T3nk4I/Minisumo/PCBS/Boards/Tei/Production/production/bom.csv

Designator | Footprint | Quantity | Value | LCSC Part #
A1_3, A1_2, A1 | Arduino_Nano | 3 | Arduino_Nano_v3.x
BLUETOOTH ADAPTER_3, BLUETOOTH ADAPTER_2, BLUETOOTH ADAPTER, REMOTE_3, REMOTE_2, REMOTE | PinSocket_1x04_P2.54mm_Vertical | 6 | Conn_01x04_Socket
C1_3, C1_2, C1 | 0805 | 3 | 10uf
C2_3, C2_2, C2 | 0805 | 3 | 22uf
C3_3, C3_2, C3, C4_3, C4_2, C4 | 0805 | 6 | 0.1uF
C5_3, C5_2, C5 | CP_EIA-3216-18_Kemet-A | 3 | 10uf
D1_3, D1_2, D1 | 0805 | 3 | LED
H1_3, H1_2, H1, H2_3, H2_2, H2, H3_3, H3_2, H3, H4_3, H4_2, H4 | MountingHole_2.2mm_M2 | 12 | MountingHole
J1_3, J1_2, J1 | AMASS_XT30U-F_1x02_P5.0mm_Vertical | 3 | Conn_01x02_Socket
J12_3, J12_2, J12, J2_3, J2_2, J2, J3_3, J3_2, J3, J4_3, J4_2, J4, J5_3, J5_2, J5, J6_3, J6_2, J6, J7_3, J7_2, J7, J8_3, J8_2, J8, J9_3, J9_2, J9 | PinHeader_1x03_P2.54mm_Vertical | 27 | Conn_01x03_Pin
J13_3, J13_2, J13, J14_3, J14_2, J14 | JST_XH_B2B-XH-A_1x02_P2.50mm_Vertical | 6 | Conn_01x02_Socket
R1_3, R1_2, R1 | 0805 | 3 | 300
R2_3, R2_2, R2, R3_3, R3_2, R3, R4_3, R4_2, R4, R5_3, R5_2, R5 | 0805 | 12 | 4.7k
SW1_3, SW1_2, SW1 | SW_SPDT_PCM12 | 3 | SW_SPDT
SW2_3, SW2_2, SW2 | Nidec_Copal_SH-7010A | 3 | SW_Coded_SH-7010
U1_3, U1_2, U1 | SSOP-24_5.3x8.2mm_P0.65mm | 3 | TB6612FNG
U2_3, U2_2, U2 | SOT-223-3_TabPin2 | 3 | AMS1117-5.0
