T3nk4I/Minisumo/PCBS/Boards/Tenn/Tenn.csv

Reference | Value | Datasheet | Footprint | Qty | DNP
A1 | Arduino_Nano_v3.x | http://www.mouser.com/pdfdocs/Gravitech_Arduino_Nano3_0.pdf | Module:Arduino_Nano | 1
C1,C2 | C | ~ | Capacitor_SMD:C_0805_2012Metric_Pad1.18x1.45mm_HandSolder | 2
C3,C4 | 0.1uF | ~ | Capacitor_SMD:C_0805_2012Metric_Pad1.18x1.45mm_HandSolder | 2
C5,C6 | 47uF | ~ | Capacitor_SMD:C_1206_3216Metric_Pad1.33x1.80mm_HandSolder | 2
J1 | Conn_01x02_Socket | ~ | Connector_AMASS:AMASS_XT30U-M_1x02_P5.0mm_Vertical | 1
J12 | Conn_01x04_Female | ~ | Connector_PinSocket_2.54mm:PinSocket_1x04_P2.54mm_Vertical | 1
J13,J14,J15 | Conn_01x03_Male | ~ | Connector_PinHeader_2.54mm:PinHeader_1x03_P2.54mm_Vertical,Connector_PinSocket_2.54mm:PinSocket_1x03_P2.54mm_Vertical | 3
J16,J17 | Conn_01x02_Male | ~ | Connector_JST:JST_XH_B2B-XH-A_1x02_P2.50mm_Vertical | 2
J18 | Conn_01x30_Pin | ~ | Connector_PinSocket_2.54mm:PinSocket_1x30_P2.54mm_Vertical | 1
R1,R2 | R | ~ | Resistor_SMD:R_0805_2012Metric_Pad1.20x1.40mm_HandSolder | 2
R3,R4 | 18k | ~ | Resistor_SMD:R_0805_2012Metric_Pad1.20x1.40mm_HandSolder | 2
SW2,SW3 | SW_Push | ~ | Button_Switch_SMD:SW_Push_1P1T_NO_Vertical_Wuerth_434133025816 | 2
SW4 | SW_SPDT | ~ | Button_Switch_THT:SW_Slide_SPDT_Straight_CK_OS102011MS2Q | 1
U1 | L7805 | http://www.st.com/content/ccc/resource/technical/document/datasheet/41/4f/b3/b0/12/d4/47/88/CD00000444.pdf/files/CD00000444.pdf/jcr:content/translations/en.CD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 | Package_TO_SOT_SMD:TO-252-2 | 1
U2,U3 | DRV8871DDA | http://www.ti.com/lit/ds/symlink/drv8871.pdf | Package_SO:Texas_HTSOP-8-1EP_3.9x4.9mm_P1.27mm_EP2.95x4.9mm_Mask2.4x3.1mm_ThermalVias | 2
