T3nk4I/Minisumo/PCBS/Boards/Ma/Ma/Ma.csv

Reference | Qty | Value | DNP | Exclude from BOM | Exclude from Board | Footprint | Datasheet
C1,C2,C3,C5,C10,C13 | 6 | 0.1uF |  |  |  | Capacitor_SMD:C_0805_2012Metric | ~
C4 | 1 | 4.7uF |  |  |  | Capacitor_SMD:C_0805_2012Metric | ~
C11,C12 | 2 | 470uF |  |  |  | Capacitor_SMD:CP_Elec_8x10.5 | ~
D1,D2 | 2 | LED |  |  |  | LED_SMD:LED_0603_1608Metric | ~
H1,H2,H3,H4 | 4 | MountingHole |  | Excluded from BOM |  | MountingHole:MountingHole_2.2mm_M2 | ~
J1 | 1 | Conn_01x02_Socket |  |  |  | Connector_AMASS:AMASS_XT30U-M_1x02_P5.0mm_Vertical | ~
J2,J9 | 2 | Conn_01x04_Socket |  |  |  | Connector_PinSocket_2.54mm:PinSocket_1x04_P2.54mm_Vertical | ~
J3,J4 | 2 | Conn_01x02_Pin |  |  |  | Connector_JST:JST_XH_B2B-XH-A_1x02_P2.50mm_Vertical | ~
J5 | 1 | Conn_01x03_Pin |  |  |  | Package_TO_SOT_SMD:TO-252-2 | ~
J7 | 1 | Conn_01x03_Pin |  |  |  | EasyEDA:HDR-SMD_3P-P2.54-H-M-W13.3-N | ~
J8 | 1 | Conn_01x06_Socket |  |  |  | EasyEDA:HDR-SMD_6P-P2.54-H-F-W11.7 | ~
J10 | 1 | Conn_01x14_Pin |  |  |  | Connector_PinHeader_2.54mm:PinHeader_1x14_P2.54mm_Vertical | ~
R1,R2,R3,R4,R5,R6,R7 | 7 | R |  |  |  | Resistor_SMD:R_0603_1608Metric | ~
SW1 | 1 | SW_Push |  |  |  | Button_Switch_SMD:SW_Push_SPST_NO_Alps_SKRK | ~
SW2 | 1 | SW_SPDT |  |  |  | EasyEDA:SW-TH_XKB_SS-12M11XX | ~
SW3,SW4 | 2 | SW_Push |  |  |  | Button_Switch_SMD:SW_SPST_PTS810 | ~
U1 | 1 | ATmega328P-M |  |  |  | Package_DFN_QFN:QFN-32-1EP_5x5mm_P0.5mm_EP3.1x3.1mm | http://ww1.microchip.com/downloads/en/DeviceDoc/ATmega328_P%20AVR%20MCU%20with%20picoPower%20Technology%20Data%20Sheet%2040001984A.pdf
U3,U4 | 2 | ~ |  |  |  | Package_SO:SOP-8_3.9x4.9mm_P1.27mm
Y1 | 1 | Crystal |  |  |  | Crystal:Crystal_SMD_3215-2Pin_3.2x1.5mm | ~
