T3nk4I/Minisumo/PCBS/Boards/Inn BEC/Production/production/bom.csv

Designator | Footprint | Quantity | Value | LCSC Part #
C1_40, C1_39, C1_38, C1_37, C1_36, C1_35, C1_34, C1_33, C1_32, C1_31, C1_30, C1_29, C1_28, C1_27, C1_26, C1_25, C1_24, C1_23, C1_22, C1_21, C1_20, C1_19, C1_18, C1_17, C1_16, C1_15, C1_14, C1_13, C1_12, C1_11, C1_10, C1_9, C1_8, C1_7, C1_6, C1_5, C1_4, C1_3, C1_2, C1 | 0805 | 40 | 22uF
C2_40, C2_39, C2_38, C2_37, C2_36, C2_35, C2_34, C2_33, C2_32, C2_31, C2_30, C2_29, C2_28, C2_27, C2_26, C2_25, C2_24, C2_23, C2_22, C2_21, C2_20, C2_19, C2_18, C2_17, C2_16, C2_15, C2_14, C2_13, C2_12, C2_11, C2_10, C2_9, C2_8, C2_7, C2_6, C2_5, C2_4, C2_3, C2_2, C2 | 1210 | 40 | 47uF
D1_40, D1_39, D1_38, D1_37, D1_36, D1_35, D1_34, D1_33, D1_32, D1_31, D1_30, D1_29, D1_28, D1_27, D1_26, D1_25, D1_24, D1_23, D1_22, D1_21, D1_20, D1_19, D1_18, D1_17, D1_16, D1_15, D1_14, D1_13, D1_12, D1_11, D1_10, D1_9, D1_8, D1_7, D1_6, D1_5, D1_4, D1_3, D1_2, D1 | D_SMA | 40 | D_Schottky
J1_40, J1_39, J1_38, J1_37, J1_36, J1_35, J1_34, J1_33, J1_32, J1_31, J1_30, J1_29, J1_28, J1_27, J1_26, J1_25, J1_24, J1_23, J1_22, J1_21, J1_20, J1_19, J1_18, J1_17, J1_16, J1_15, J1_14, J1_13, J1_12, J1_11, J1_10, J1_9, J1_8, J1_7, J1_6, J1_5, J1_4, J1_3, J1_2, J1, J2_40, J2_39, J2_38, J2_37, J2_36, J2_35, J2_34, J2_33, J2_32, J2_31, J2_30, J2_29, J2_28, J2_27, J2_26, J2_25, J2_24, J2_23, J2_22, J2_21, J2_20, J2_19, J2_18, J2_17, J2_16, J2_15, J2_14, J2_13, J2_12, J2_11, J2_10, J2_9, J2_8, J2_7, J2_6, J2_5, J2_4, J2_3, J2_2, J2 | SolderWire-0.1sqmm_1x02_P3.6mm_D0.4mm_OD1mm | 80 | Conn_01x02_Pin
L1_40, L1_39, L1_38, L1_37, L1_36, L1_35, L1_34, L1_33, L1_32, L1_31, L1_30, L1_29, L1_28, L1_27, L1_26, L1_25, L1_24, L1_23, L1_22, L1_21, L1_20, L1_19, L1_18, L1_17, L1_16, L1_15, L1_14, L1_13, L1_12, L1_11, L1_10, L1_9, L1_8, L1_7, L1_6, L1_5, L1_4, L1_3, L1_2, L1 | L_Bourns-SRN4018 | 40 | 68uH
U1_40, U1_39, U1_38, U1_37, U1_36, U1_35, U1_34, U1_33, U1_32, U1_31, U1_30, U1_29, U1_28, U1_27, U1_26, U1_25, U1_24, U1_23, U1_22, U1_21, U1_20, U1_19, U1_18, U1_17, U1_16, U1_15, U1_14, U1_13, U1_12, U1_11, U1_10, U1_9, U1_8, U1_7, U1_6, U1_5, U1_4, U1_3, U1_2, U1 | SOIC-8_3.9x4.9mm_P1.27mm | 40 | XL1509-5.0
