T3nk4I/Minisumo/PCBS/Sensors/QTMicro/Pinout and component placement.png

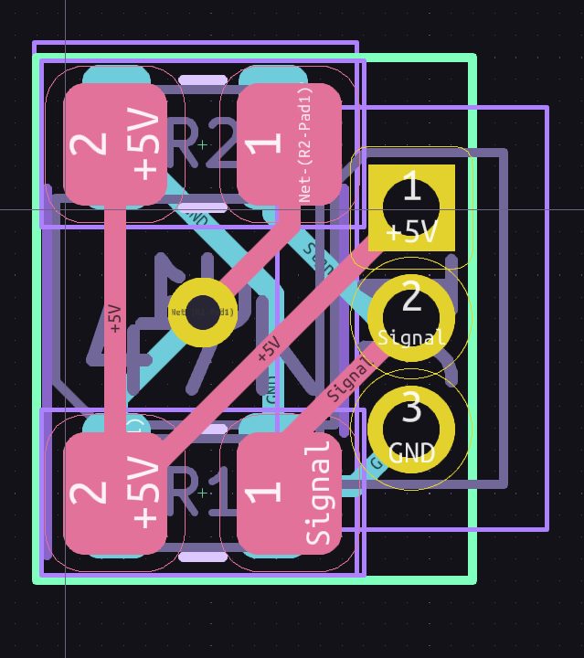
PCBS/Sensors/QTMicro/Pinout and component placement.png
