T3nk4I/Minisumo/3D data/Flag system/Damashi Flag system.iges

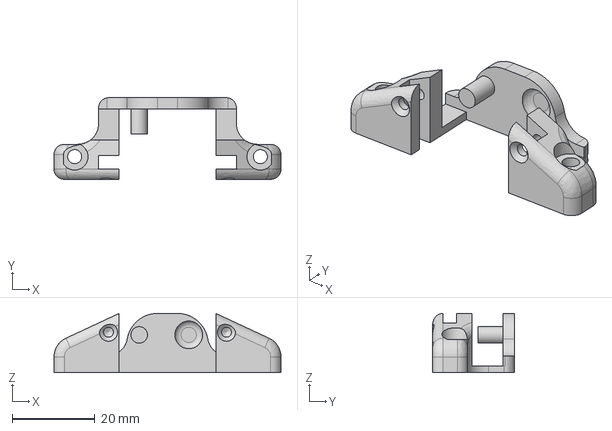
[picture p2: CAD file, 2024-06-04]
3D data/Flag system/Damashi Flag system.iges
55.0 x 19.8 x 14.4 mm
