T3nk4I/Minisumo/3D data/Motor Brackets/Jin/Jin v2.iges

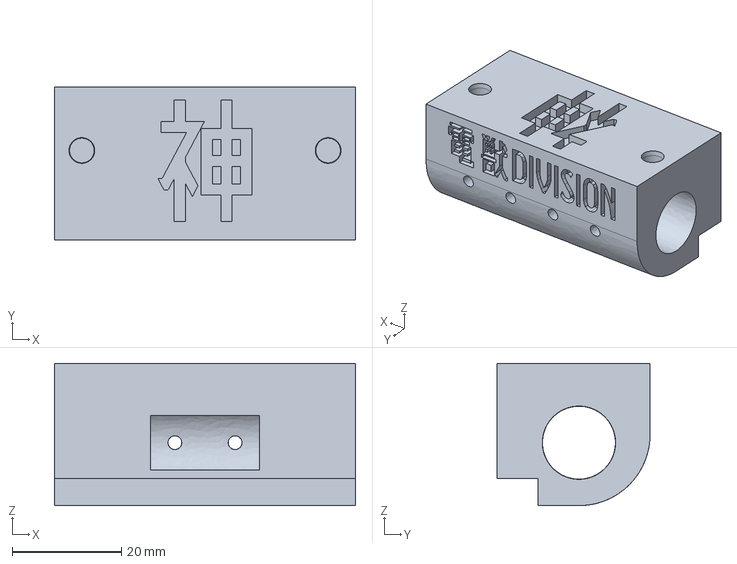
[picture p3: CAD file, 2024-02-26]
3D data/Motor Brackets/Jin/Jin v2.iges
55.0 x 28.0 x 26.0 mm
