T3nk4I/Minisumo/3D data/Motor Brackets/Oh/Oh-Motor Bracket v28.iges

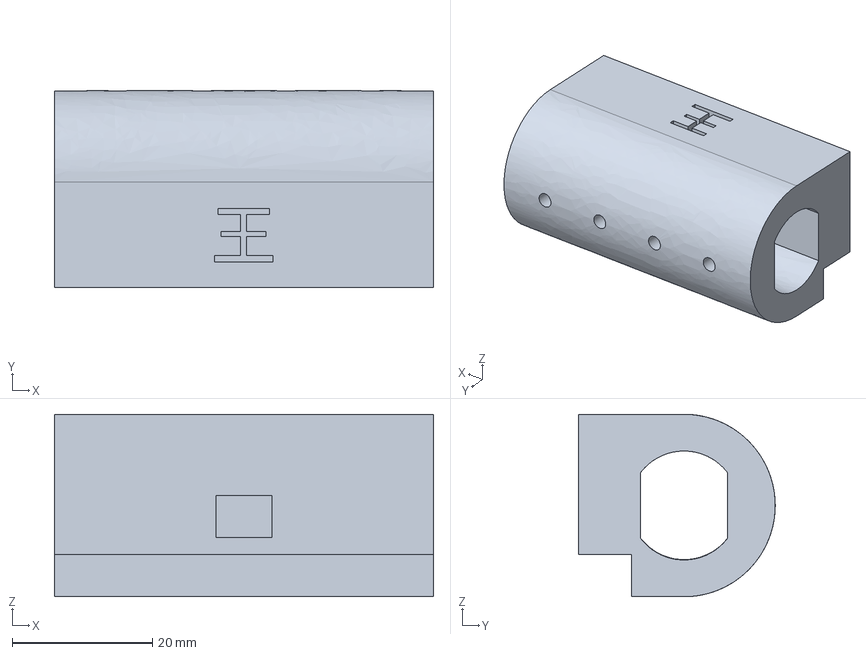
[picture p4: CAD file, 2024-02-26]
3D data/Motor Brackets/Oh/Oh-Motor Bracket v28.iges
54.0 x 28.0 x 26.0 mm
