T3nk4I/Minisumo/3D data/Robots/Gyu-Ma-Oh/Gyu Base.iges

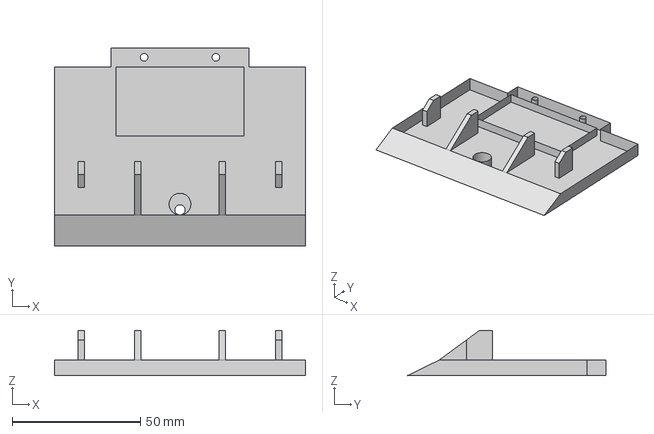
[picture p5: CAD file, 2024-05-06]
3D data/Robots/Gyu-Ma-Oh/Gyu Base.iges
98.0 x 77.5 x 17.6 mm
