T3nk4I/Minisumo/3D data/Robots/K1tsun3/Base-K1tsun3.iges

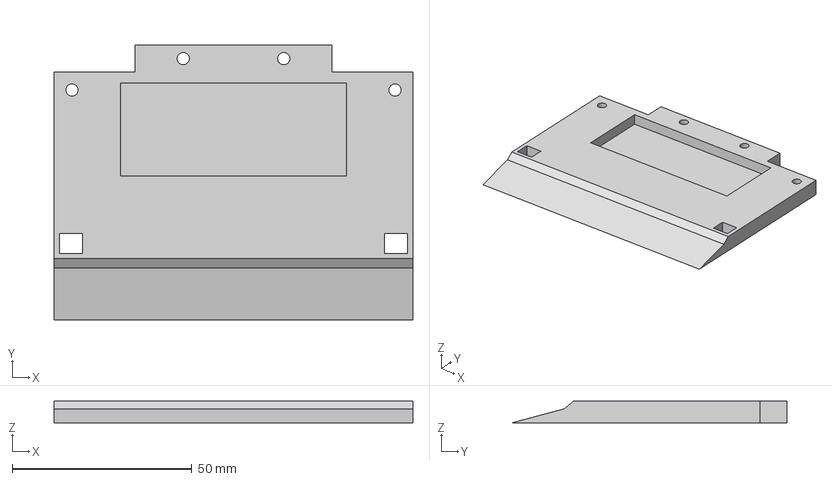
[picture p6: CAD file, 2024-05-06]
3D data/Robots/K1tsun3/Base-K1tsun3.iges
100.0 x 76.5 x 6.00 mm
