T3nk4I/Minisumo/3D data/Robots/T4nook1/Chasis T4nook1 Jsumo-Ver.iges

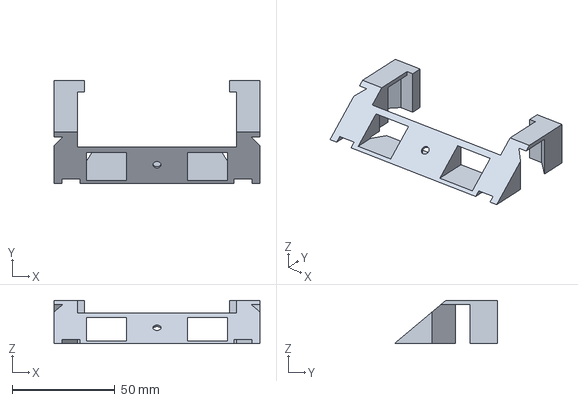
[picture p7: CAD file, 2024-05-06]
3D data/Robots/T4nook1/Chasis T4nook1 Jsumo-Ver.iges
100.0 x 50.2 x 21.0 mm
