T3nk4I/Minisumo/Microsumos/3D files/Wheel.stl

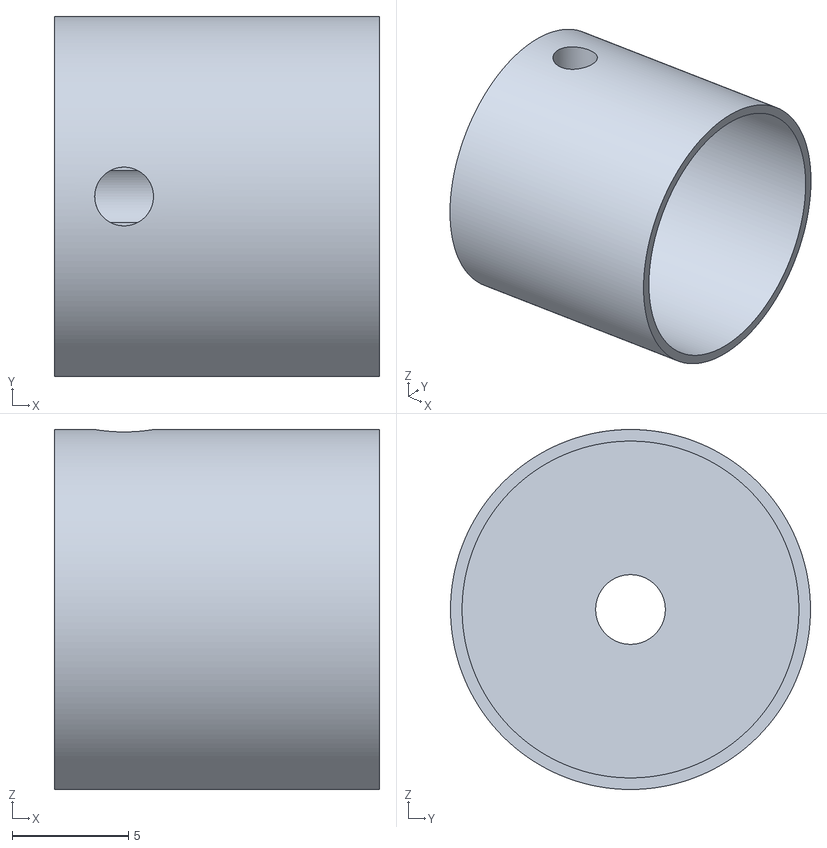
[picture p8: CAD file, 2023-09-21]
Microsumos/3D files/Wheel.stl
14.0 x 15.5 x 15.5
