T3nk4I/Minisumo/3D data/Flag system/Gear Right Flag system long stem.stl

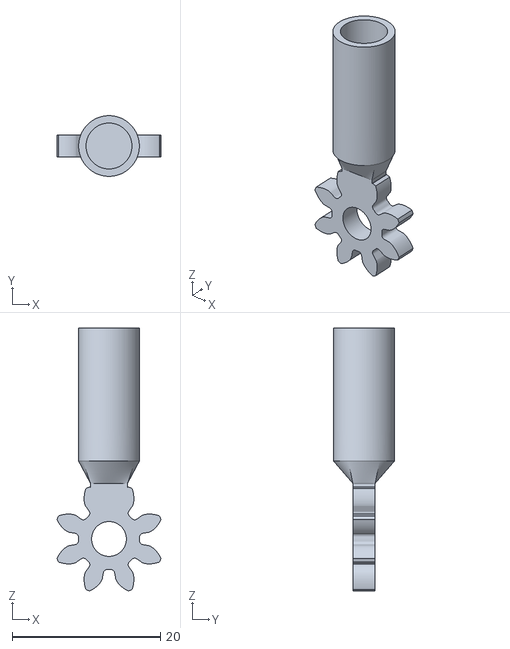
[picture p9: CAD file, 2024-06-04]
3D data/Flag system/Gear Right Flag system long stem.stl
14.1 x 8.20 x 35.5
