T3nk4I/Minisumo/3D data/Robots/Gyu-Ma-Oh/Chasis Gyu-Ma-Oh.iges

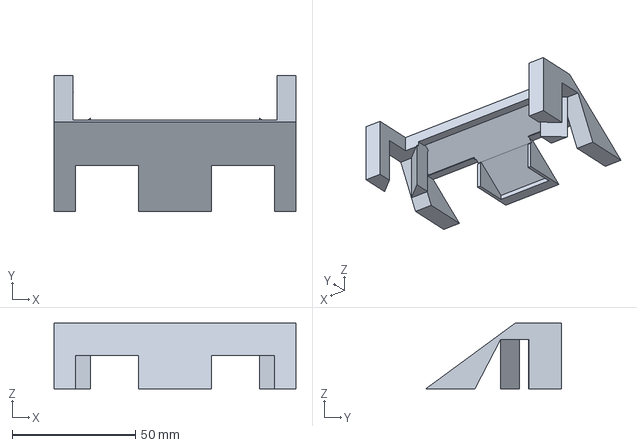
[picture p10: CAD file, 2024-05-06]
3D data/Robots/Gyu-Ma-Oh/Chasis Gyu-Ma-Oh.iges
98.0 x 55.0 x 26.6 mm
