T3nk4I/Minisumo/3D data/Robots/K1tsun3/Chasis K1tsun3.iges

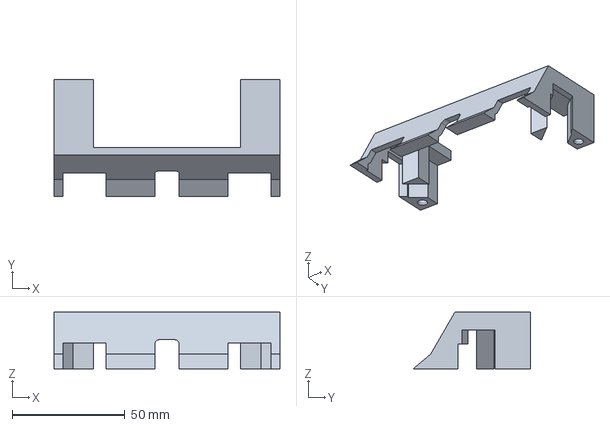
[picture p11: CAD file, 2024-05-06]
3D data/Robots/K1tsun3/Chasis K1tsun3.iges
100.0 x 52.0 x 25.0 mm
