T3nk4I/Minisumo/3D data/Robots/T4nook1/Base T4nook1.iges

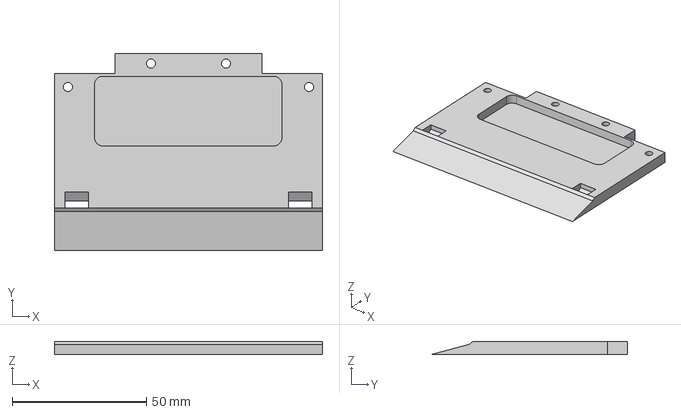
[picture p12: CAD file, 2024-05-06]
3D data/Robots/T4nook1/Base T4nook1.iges
100.0 x 73.5 x 5.00 mm
