T3nk4I/Minisumo/Microsumos/3D files/Wheel with gear.stl

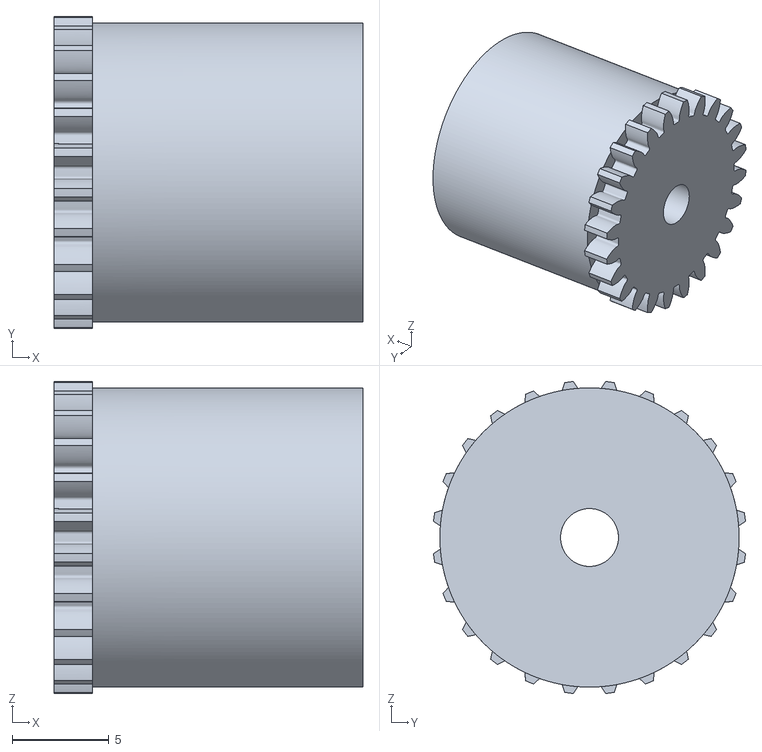
[picture p13: CAD file, 2023-09-21]
Microsumos/3D files/Wheel with gear.stl
16.0 x 16.2 x 16.2
