T3nk4I/Minisumo/3D data/Flag system/Gear Left Flag system long stem.stl

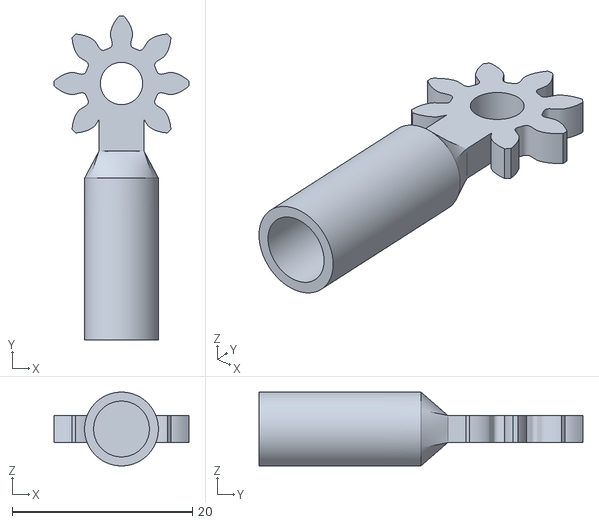
[picture p14: CAD file, 2024-06-04]
3D data/Flag system/Gear Left Flag system long stem.stl
15.0 x 36.0 x 8.20
