T3nk4I/Minisumo/Microsumos/3D files/Base.stl

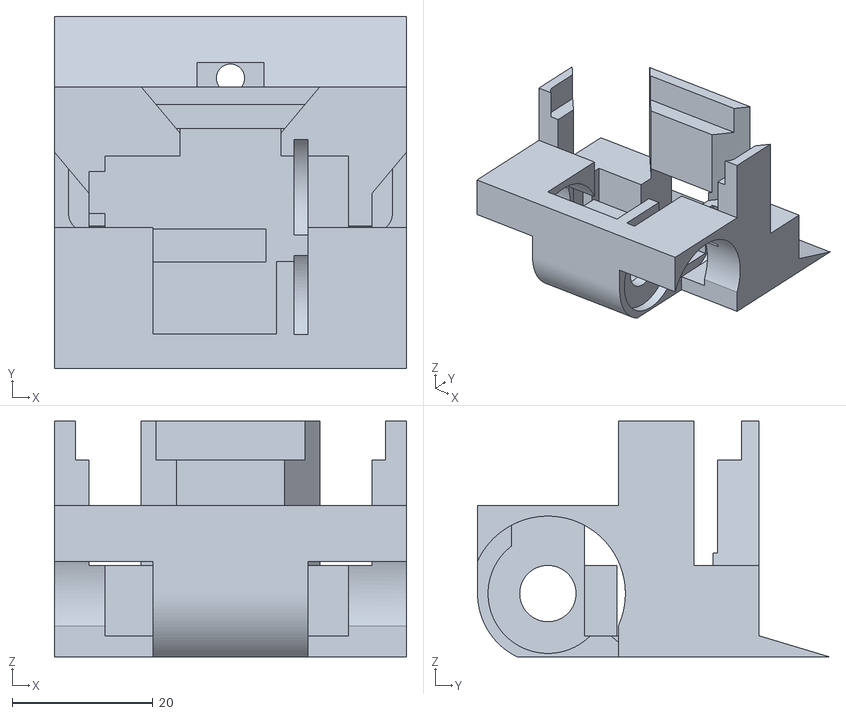
[picture p15: CAD file, 2023-09-21]
Microsumos/3D files/Base.stl
50.0 x 50.0 x 33.5
