T3nk4I/Minisumo/3D data/Flag system/Gear Right.iges

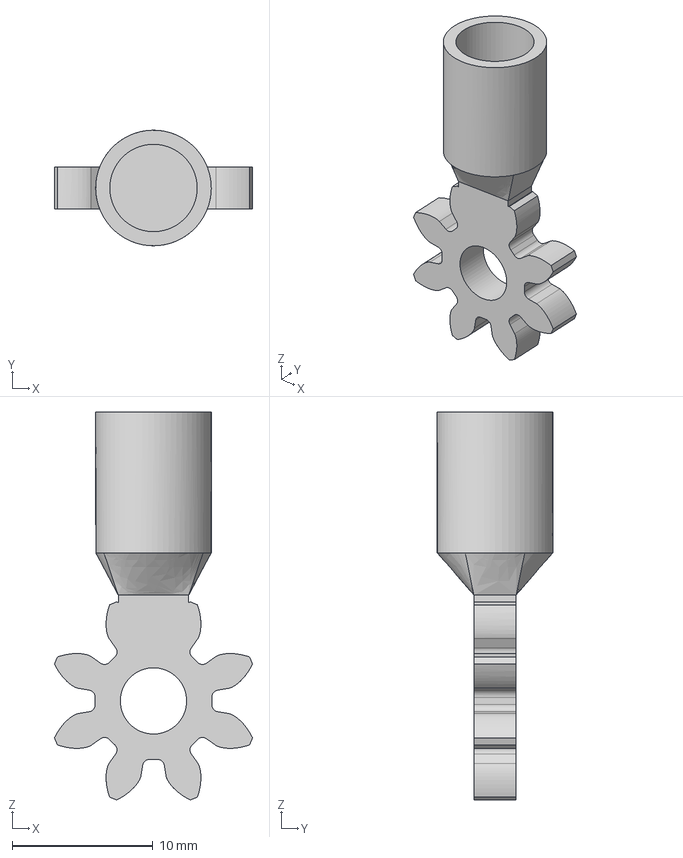
[picture p16: CAD file, 2023-11-21]
3D data/Flag system/Gear Right.iges
14.1 x 8.20 x 27.5 mm
