T3nk4I/Minisumo/Microsumos/3D files/Spur Gear (24 teeth).stl

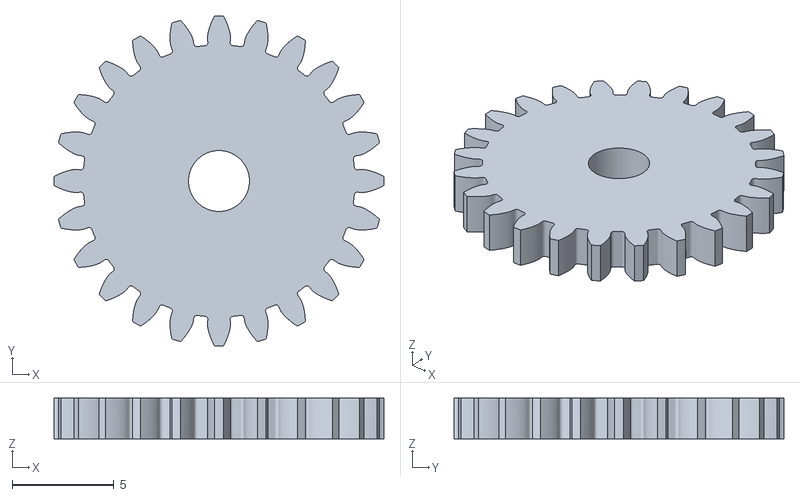
[picture p17: CAD file, 2023-09-21]
Microsumos/3D files/Spur Gear (24 teeth).stl
16.2 x 16.2 x 2.00
