T3nk4I/Minisumo/3D data/Flag system/Gear Left.iges

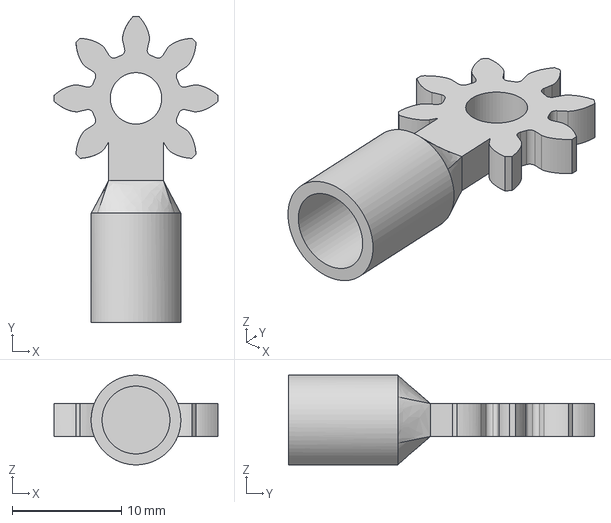
[picture p18: CAD file, 2023-11-21]
3D data/Flag system/Gear Left.iges
15.0 x 28.0 x 8.19 mm
