T3nk4I/Minisumo/(list of files, cad)

Other CAD files:
3D data/Motor Brackets/Ma-Jin/Ma-Jin.iges
3D data/Flag system/Damashi Flag system.stl
3D data/Flag system/Gear Left.stl
3D data/Flag system/Gear Right.stl
3D data/Motor Brackets/Jin/Jin v2.stl
3D data/Motor Brackets/Ma-Jin/Ma-Jin.stl
3D data/Motor Brackets/Oh/Oh-Motor Bracket v28.stl
