T3nk4I/Minisumo/(threads)

Thread 1 (2024-07-10):

Wrong orientation and malfunctioning of the buttons in Tenn board

T3nk4I, 2024-07-10:
The OLED Screen Direction in the Tenn Board covers the buttons instead of the arduino nano as planned.
The push buttons don't pass current to the MCU, thus not detecting the input, making the buttons obsolete.

AT4NI, 2024-07-10:
Buttons do not work, do it again.

T3nk4I, 2024-07-10:
Tenn rev2.2 is now avaiable, (gerber files soon), fixes the buttons not working, the screen orientation and replaces the tantalum capacitors with more avaiable 0805 package capacitors, also uses a pin socket switch that should support up to 50V, so now it's possible to use the board with 6S (yet to be tested).

Closed 2024-07-10.

Thread 4 (2025-05-15):

Error de tipeo

FranJx, 2025-05-15:
en la documentacion de las pcb desarrolladas se encuentra escrito "drv7781" en vez de (correctamente) drv8871 🤬

Closed 2025-05-15.
