T3nk4I/Minisumo/PCBS/Boards/Tenn/Tenn.pdf

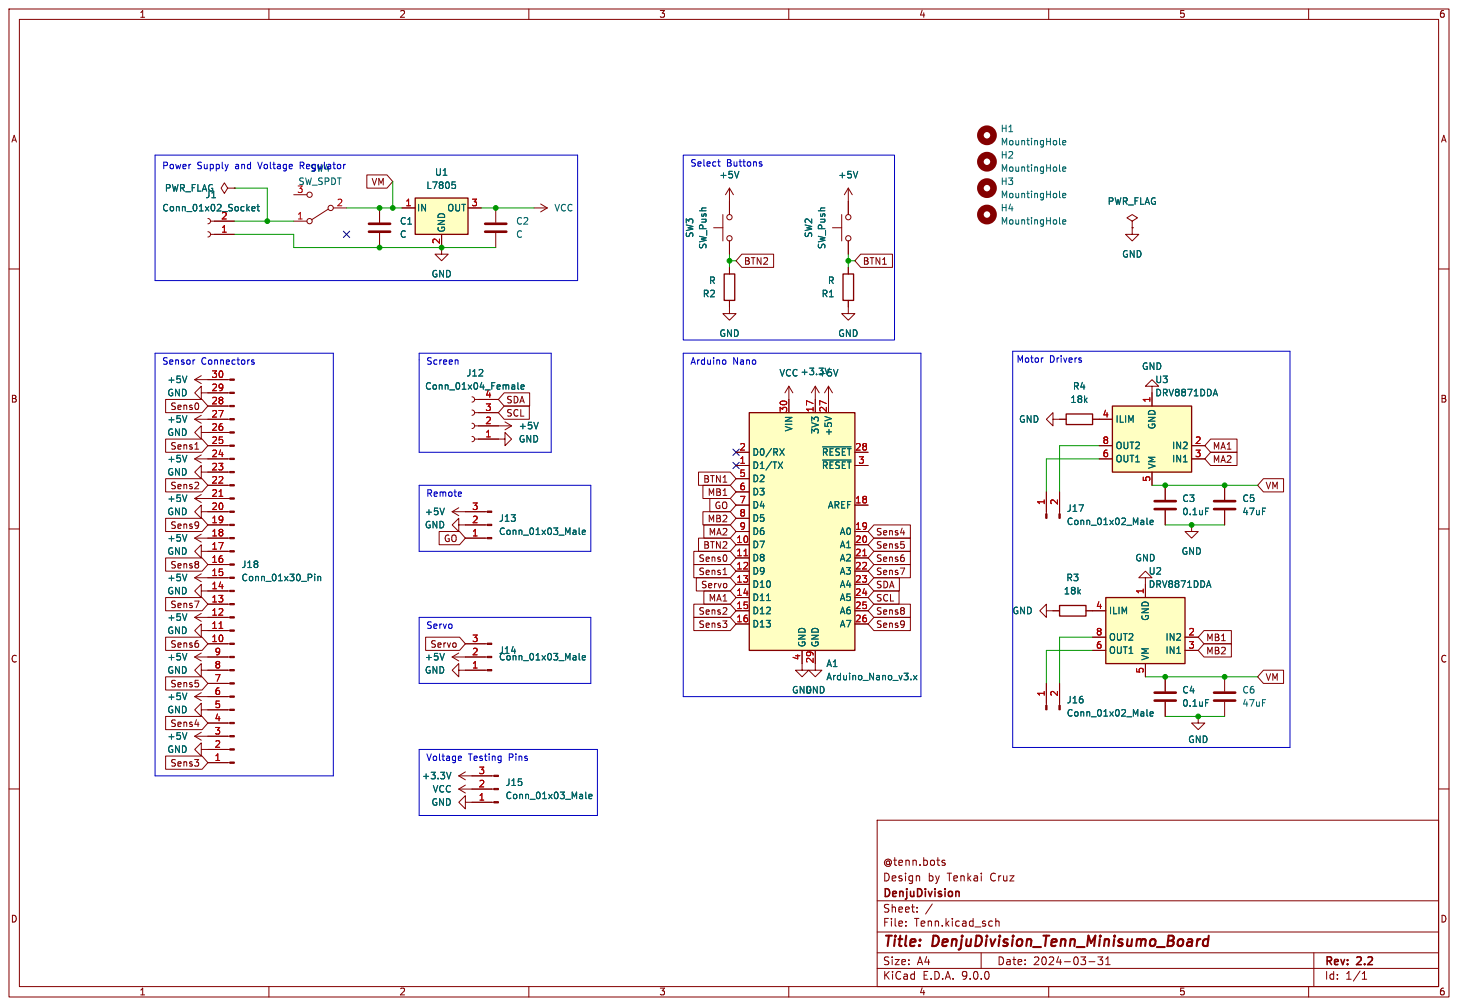
[picture p19: page 1]

File: Tenn.kicad_sch Sheet: / DenjuDivision
