T3nk4I/Minisumo/PCBS/Sensors/QTMicro/QTR mini.pdf

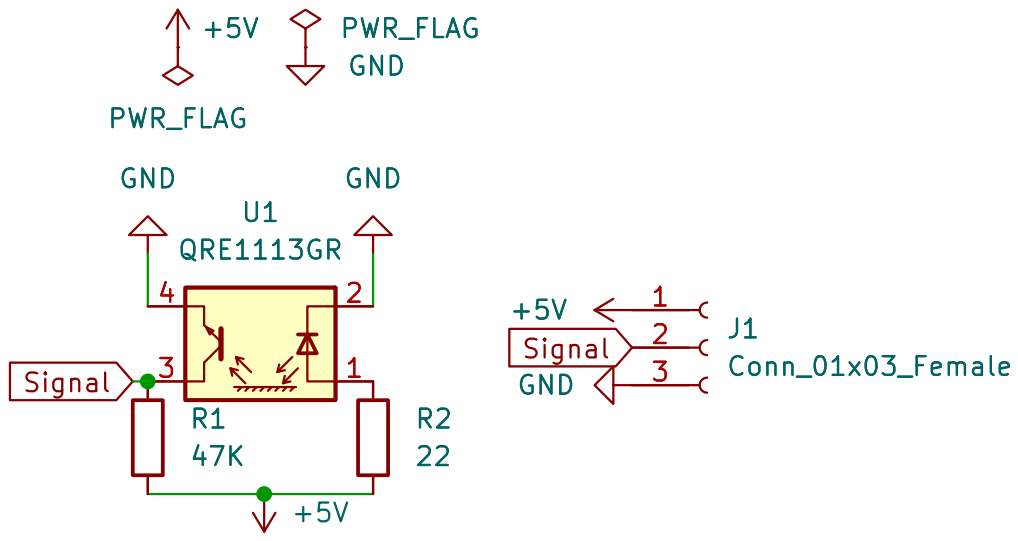
[picture p20: page 1]

Signal R1
File: QTR mini.kicad_sch Sheet: / DENJU DIVISION Made by T3nk4I R1
