T3nk4I/Minisumo/PCBS/Boards/Ma/Ma/Ma.pdf

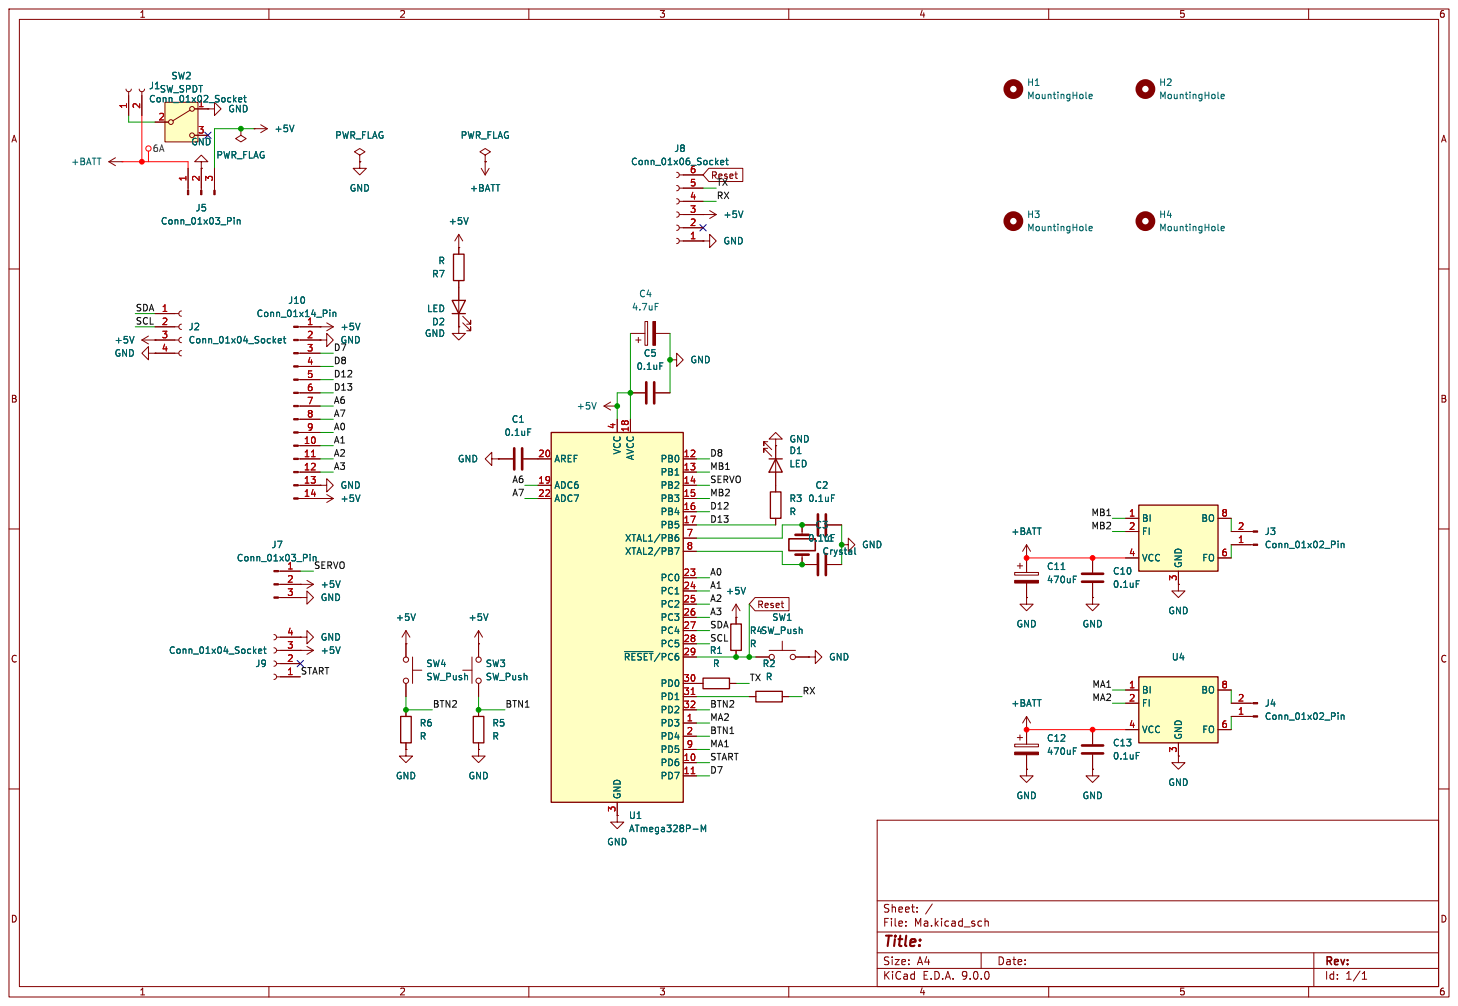
[picture p21: page 1]

3 BO 8 FO 6 BI 1 FI 2 VCC 4 GND
