T3nk4I/Minisumo/PCBS/Boards/Tei/Tei.pdf

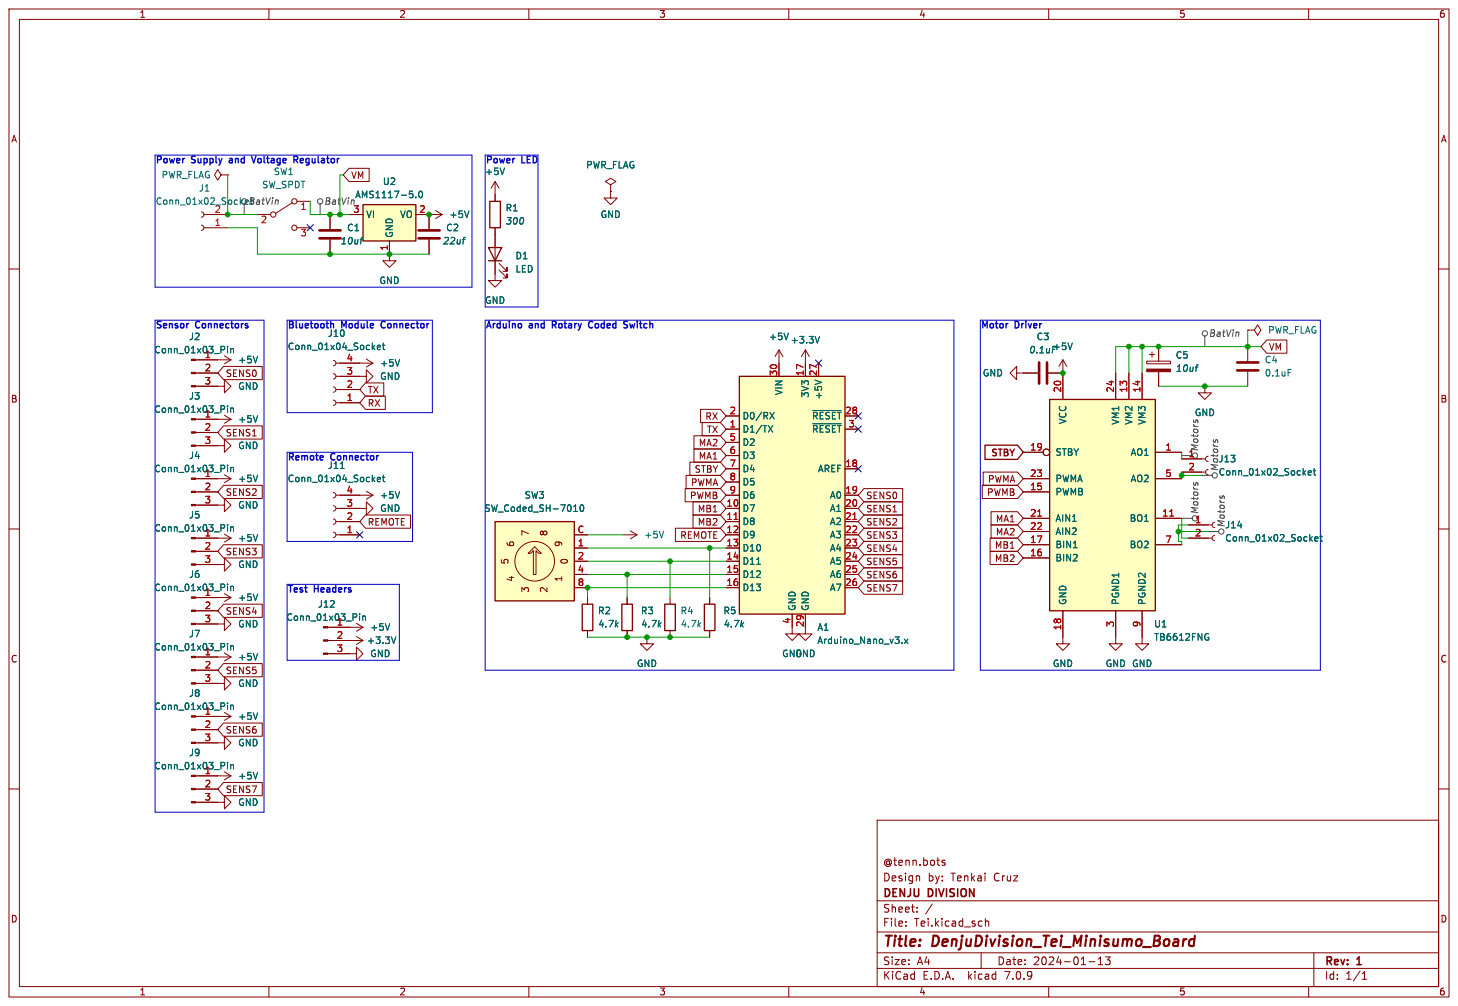
[picture p22: page 1]
