T3nk4I/Minisumo/PCBS/Boards/Shu BEC/Shu BEC.kicad_pcb

## KiCad design PCBS/Boards/Shu BEC/Shu BEC.kicad_pcb (2026-07-19)

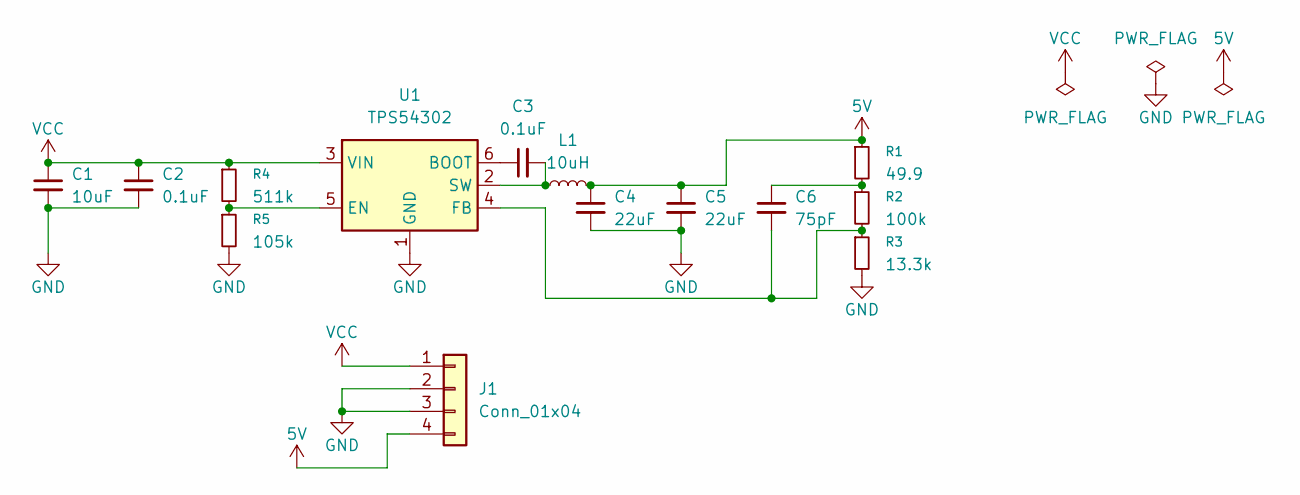
[picture p25: schematic Shu BEC.kicad_sch, Shu 5V BEC]

Parts:
C1: 10uF; C_0603_1608Metric
C2, C3: 0.1uF; C_0201_0603Metric
C4, C5: 22uF; C_1206_3216Metric
C6: 75pF; C_0201_0603Metric
J1: Conn_01x04; PinSocket_1x04_P2.54mm_Vertical
L1: 10uH; L_Sunlord_MWSA0518S
R1: 49.9; R_0201_0603Metric
R2: 100k; R_0201_0603Metric
R3: 13.3k; R_0201_0603Metric
R4: 511k; R_0201_0603Metric
R5: 105k; R_0201_0603Metric
U1: TPS54302; SOT-23-6

Connections:
5V: C4.1, C5.1, J1.4, L1.2, R1.1
GND: C1.2, C2.2, C4.2, C5.2, J1.2, J1.3, R3.2, R5.2, U1.1 (GND)
unnamed: C6.1, R1.2, R2.1
unnamed: C3.1, U1.6 (BOOT)
unnamed: R4.2, R5.1, U1.5 (EN)
unnamed: C6.2, R2.2, R3.1, U1.4 (FB)
unnamed: C3.2, L1.1, U1.2 (SW)
VCC: C1.1, C2.1, J1.1, R4.1, U1.3 (VIN)

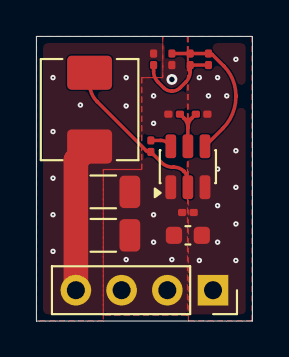
[picture p26: board Shu BEC.kicad_pcb from above]

Board: 2 copper layers, 12.0 x 15.8 mm, 14 parts (0 on the bottom side), 8 nets.
