T3nk4I/Minisumo/PCBS/Boards/Tenn/Tenn.kicad_pcb

## KiCad design PCBS/Boards/Tenn/Tenn.kicad_pcb (2026-07-19)

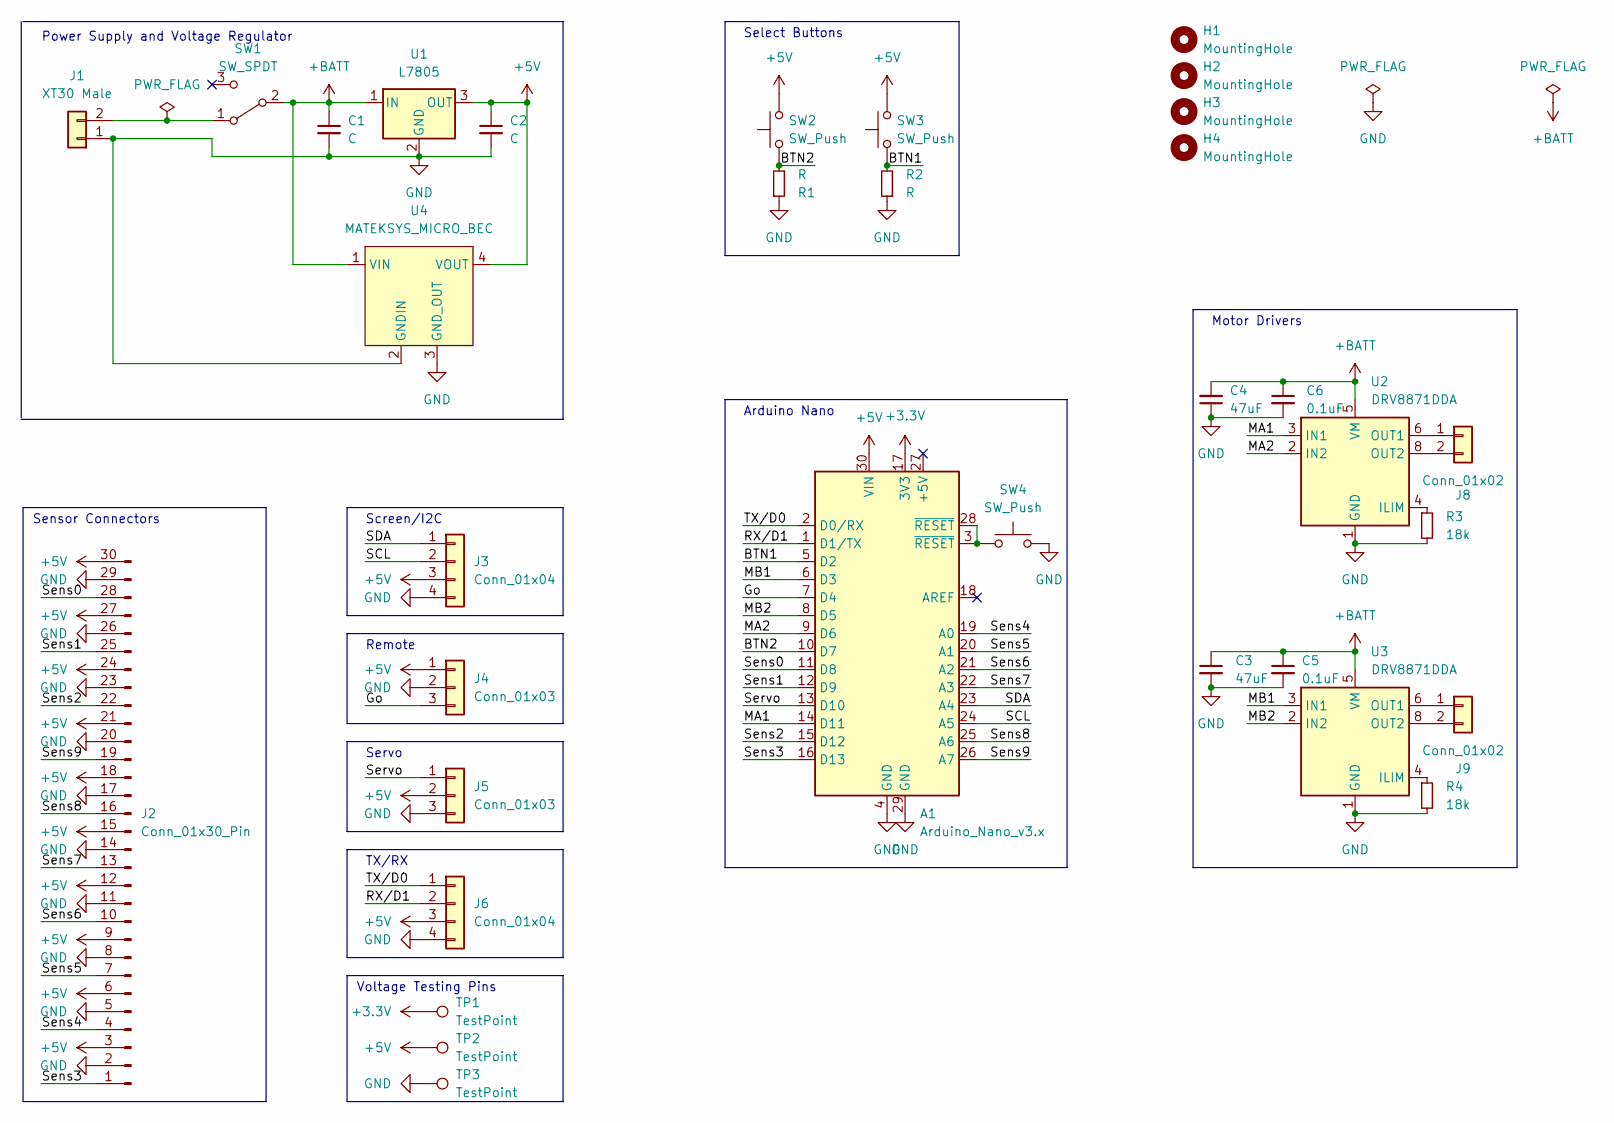
[picture p27: schematic Tenn.kicad_sch, DenjuDivision_Tenn_Minisumo_Board]

Parts:
A1: Arduino_Nano_v3.x; Arduino_Nano
C1, C2: C; C_0805_2012Metric_Pad1.18x1.45mm_HandSolder
C3, C4: 47uF; C_1206_3216Metric_Pad1.33x1.80mm_HandSolder
C5, C6: 0.1uF; C_0805_2012Metric_Pad1.18x1.45mm_HandSolder
H1, H2, H3, H4: MountingHole; MountingHole_2.2mm_M2_ISO7380
J1: XT30 Male; AMASS_XT30U-M_1x02_P5.0mm_Vertical
J2: Conn_01x30_Pin; PinSocket_1x30_P2.54mm_Vertical
J3, J6: Conn_01x04; PinSocket_1x04_P2.54mm_Vertical
J4: Conn_01x03; PinSocket_1x03_P2.54mm_Vertical
J5: Conn_01x03; PinHeader_1x03_P2.54mm_Vertical
J8, J9: Conn_01x02; JST_XH_B2B-XH-A_1x02_P2.50mm_Vertical
R1, R2: R; R_0805_2012Metric_Pad1.20x1.40mm_HandSolder
R3, R4: 18k; R_0805_2012Metric_Pad1.20x1.40mm_HandSolder
SW1: SW_SPDT; SW_Slide_SPDT_Straight_CK_OS102011MS2Q
SW2, SW3: SW_Push; SW_Push_1P1T_NO_Vertical_Wuerth_434133025816
SW4: SW_Push; SW_SPST_B3U-1000P
TP1, TP2, TP3: TestPoint; TestPoint-0.75mm
U1: L7805; TO-252-2
U2, U3: DRV8871DDA; Texas_HTSOP-8-1EP_3.9x4.9mm_P1.27mm_EP2.95x4.9mm_Mask2.4x3.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
U4: MATEKSYS_MICRO_BEC; MATEKSYS MICRO BEC

Connections:
+3.3V: A1.17 (3V3), TP1.1 (1_1)
+5V: A1.30 (VIN), C2.1, J2.3, J2.6, J2.9, J2.12, J2.15, J2.18, J2.21, J2.24, J2.27, J2.30, J3.3, J4.1, J5.2, J6.3, SW2.2, SW3.2, TP2.1 (1_1), U1.3 (OUT), U4.4 (VOUT)
+BATT: C1.1, C3.1, C4.2, C5.1, C6.1, SW1.2 (B), U1.1 (IN), U2.5 (VM), U3.5 (VM), U4.1 (VIN)
/BTN1: A1.5 (D2), R2.2, SW3.1
/BTN2: A1.10 (D7), R1.2, SW2.1
/Go: A1.7 (D4), J4.3
/MA1: A1.14 (D11), U2.3 (IN1)
/MA2: A1.9 (D6), U2.2 (IN2)
/MB1: A1.6 (D3), U3.3 (IN1)
/MB2: A1.8 (D5), U3.2 (IN2)
/RX/D1: A1.1 (D1/TX), J6.2
/SCL: A1.24 (A5), J3.2
/SDA: A1.23 (A4), J3.1
/Sens0: A1.11 (D8), J2.28
/Sens1: A1.12 (D9), J2.25
/Sens2: A1.15 (D12), J2.22
/Sens3: A1.16 (D13), J2.1
/Sens4: A1.19 (A0), J2.4
/Sens5: A1.20 (A1), J2.7
/Sens6: A1.21 (A2), J2.10
/Sens7: A1.22 (A3), J2.13
/Sens8: A1.25 (A6), J2.16
/Sens9: A1.26 (A7), J2.19
/Servo: A1.13 (D10), J5.1
/TX/D0: A1.2 (D0/RX), J6.1
GND: A1.4 (GND), A1.29 (GND), C1.2, C2.2, C3.2, C4.1, C5.2, C6.2, J1.1, J2.2, J2.5, J2.8, J2.11, J2.14, J2.17, J2.20, J2.23, J2.26, J2.29, J3.4, J4.2, J5.3, J6.4, R1.1, R2.1, R3.2, R4.2, SW4.2, TP3.1 (1_1), U1.2 (GND), U2.1 (GND), U2.7 (GND), U2.9 (GND), U3.1 (GND), U3.7 (GND), U3.9 (GND), U4.2 (GNDIN), U4.3 (GND_OUT)
unnamed: A1.3 (~RESET), A1.28 (~RESET), SW4.1
unnamed: J1.2, SW1.1 (A)
unnamed: J8.1, U2.6 (OUT1)
unnamed: J8.2, U2.8 (OUT2)
unnamed: J9.1, U3.6 (OUT1)
unnamed: J9.2, U3.8 (OUT2)
unnamed: R3.1, U2.4 (ILIM)
unnamed: R4.1, U3.4 (ILIM)

Notes on the sheet:
Arduino Nano
Sensor Connectors
Screen/I2C
Servo
Select Buttons
Motor Drivers
Remote
TX/RX
Power Supply and Voltage Regulator
Voltage Testing Pins

Board: 2 copper layers, 34 parts (3 on the bottom side), 34 nets, no tracks yet.
