T3nk4I/Minisumo/PCBS/Boards/Inn BEC/Inn BEC.kicad_pcb

## KiCad design PCBS/Boards/Inn BEC/Inn BEC.kicad_pcb (2026-05-15)

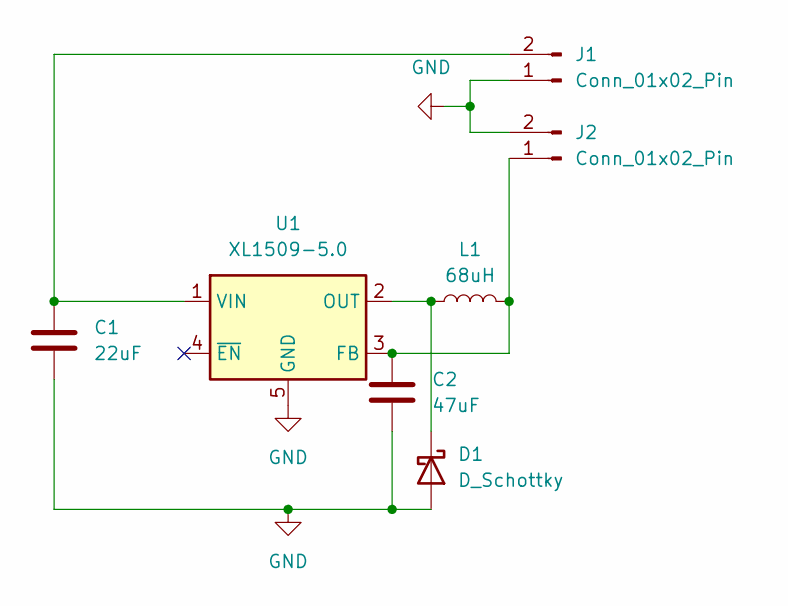
[picture p28: schematic Inn BEC.kicad_sch]

Parts:
C1: 22uF; C_0805_2012Metric_Pad1.18x1.45mm_HandSolder
C2: 47uF; C_1210_3225Metric_Pad1.33x2.70mm_HandSolder
D1: D_Schottky; D_SMA
J1, J2: Conn_01x02_Pin; SolderWire-0.1sqmm_1x02_P3.6mm_D0.4mm_OD1mm
L1: 68uH; L_Bourns-SRN4018
U1: XL1509-5.0; SOIC-8_3.9x4.9mm_P1.27mm

Connections:
GND: C1.2, C2.2, D1.2 (A), J1.1, J2.2, U1.5 (GND), U1.6 (GND), U1.7 (GND), U1.8 (GND)
unnamed: D1.1 (K), L1.1, U1.2 (OUT)
unnamed: C1.1, J1.2, U1.1 (VIN)
unnamed: C2.1, J2.1, L1.2, U1.3 (FB)

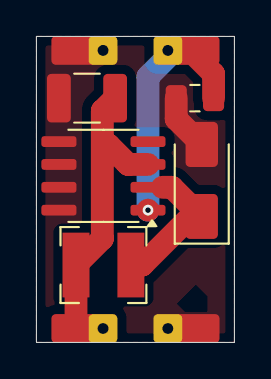
[picture p29: board Inn BEC.kicad_pcb from above]

Board: 2 copper layers, 11.0 x 17.0 mm, 7 parts (0 on the bottom side), 4 nets.
