T3nk4I/Minisumo/PCBS/Boards/UART programmer/UART programmer/UART programmer.kicad_pcb

## KiCad design PCBS/Boards/UART programmer/UART programmer/UART programmer.kicad_pcb (2025-07-28)

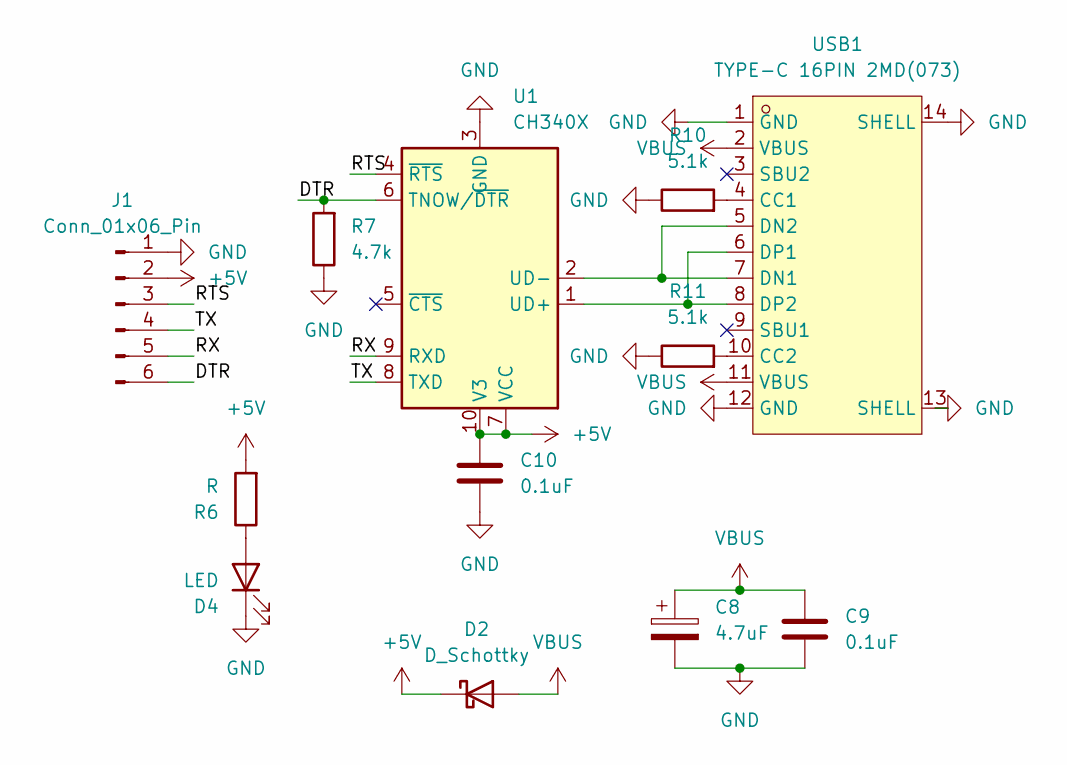
[picture p30: schematic UART programmer.kicad_sch]

Parts:
C8: 4.7uF; C_0805_2012Metric
C9, C10: 0.1uF; C_0805_2012Metric
D2: D_Schottky; D_0805_2012Metric
D4: LED; LED_0603_1608Metric
J1: Conn_01x06_Pin; JST_XH_S6B-XH-A-1_1x06_P2.50mm_Horizontal
R6: R; R_0603_1608Metric
R7: 4.7k; R_0603_1608Metric
R10, R11: 5.1k; R_0603_1608Metric
U1: CH340X; MSOP-10_3x3mm_P0.5mm
USB1: TYPE-C 16PIN 2MD(073); USB-C-SMD_TYPE-C-6PIN-2MD-073; LCSC Part C2765186

Connections:
+5V: C10.2, D2.1 (K), J1.2, R6.2, U1.7 (VCC), U1.10 (V3)
/DTR: J1.6, R7.2, U1.6 (TNOW/~DTR)
/RTS: J1.3, U1.4 (~RTS)
/RX: J1.5, U1.9 (RXD)
/TX: J1.4, U1.8 (TXD)
GND: C8.2, C9.1, C10.1, D4.1 (K), J1.1, R7.1, R10.1, R11.1, U1.3 (GND), USB1.1 (GND), USB1.12 (GND), USB1.13 (SHELL), USB1.14 (SHELL)
unnamed: D4.2 (A), R6.1
unnamed: U1.1 (UD+), USB1.6 (DP1), USB1.8 (DP2)
unnamed: U1.2 (UD-), USB1.5 (DN2), USB1.7 (DN1)
unnamed: R10.2, USB1.4 (CC1)
unnamed: R11.2, USB1.10 (CC2)
VBUS: C8.1, C9.2, D2.2 (A), USB1.2 (VBUS), USB1.11 (VBUS)

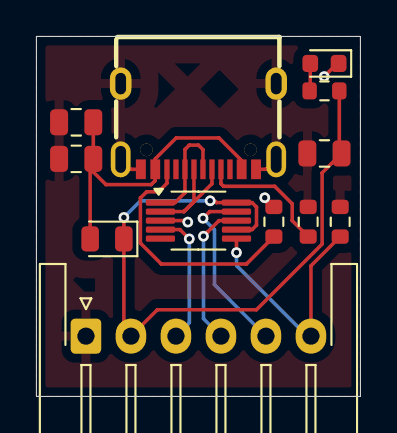
[picture p31: board UART programmer.kicad_pcb from above]

Board: 2 copper layers, 18.0 x 20.0 mm, 12 parts (0 on the bottom side), 12 nets.
