T3nk4I/Minisumo/(commit log)

2023-09-15 Added Basic
    Added Basic, program for basic minisumo robots, no line sensors, 2 opponent sensors.
2023-09-22 Uploaded new version of microsumo base
    Corrected an error with the tolerances of the space of the middle sensor
    [Base.stl]
2024-01-15 Added Tei schematic
2024-02-01 Added Gerber and BOM files
    Added gerber and BOM files optimized for production in JLCPCB
    [BOM-Tei.csv]
2024-02-26 added new 3D files for 3 different motor brackets
    [Jin v2.iges, Jin v2.stl, Ma-Jin.iges, Ma-Jin.stl, Oh-Motor Bracket v28.iges, Oh-Motor Bracket v28.stl]
2024-03-14 fixed some errors in main.cpp in I7ach1 code
    [main.cpp]
2024-03-14 Added Sensor test mode
2024-03-14 fixed issue with SensTest
    [main.cpp]
2024-03-14 fixed errors in SensTest
    [main.cpp]
2024-03-16 fixed some issues in the differents strats in Tamashi-I7ach1
    [main.cpp]
2024-03-31 Added all the KiCad files for Tei Board
    [BOM-Tei.csv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]
2024-03-31 Added extra KiCad files for easier modification of Tei Board
2024-03-31 Created Tenn Board files, added schematic, BOM and more KiCad files
    [Tenn.csv, Tenn.kicad_pcb, Tenn.kicad_sch]
2024-04-13 updated Tei board PCB, all components now in place
    [Tenn.kicad_pcb]
2024-04-13 changed Tenn PCB, all components now in place
2024-04-23 Created Tamashi K1tsun3 in /code
    [Tenn.kicad_pcb]
2024-04-28 assined correct pins in define section at main cpp in k1tsun3-tamashii
    [main.cpp]
2024-05-03 Updates nets and adds tracks in pcb file
    [Tenn.kicad_pcb, Tenn.kicad_sch]
2024-05-03 updates pcb nets and tracks
2024-05-05 updates tenn PCB board, changes some connections and netclasses
    [Tenn.kicad_pcb, Tenn.kicad_sch]
2024-05-06 uploads 3D data of bases and chasis of Gyu-Ma-Oh, T4nook1 and K1tsun3
    [Base T4nook1.iges, Base-K1tsun3.iges, Chasis Gyu-Ma-Oh.iges, Chasis K1tsun3.iges, Chasis T4nook1 Jsumo-Ver.iges, Gyu Base.iges]
2024-05-15 updates the files in Tenn PCB board
    [Tenn.kicad_pcb, Tenn.kicad_sch]
2024-05-19 updates PCB of tenn board
    [Tenn.kicad_pcb]
2024-05-21 updates tenn.pdf in tenn board
    [Tenn.kicad_sch]
2024-05-27 updates tenn board, adds gerber files, ready for production
    [Tenn.kicad_pcb, bom.csv, designators.csv, positions.csv]
2024-05-29 updates production files of tenn board
    [Tenn.kicad_pcb, designators.csv]
2024-06-04 updates damashi flag system, adds long stem versions of the gears as well
    [Damashi Flag system.iges, Damashi Flag system.stl, Gear Left Flag system long stem.stl, Gear Right Flag system long stem.stl]
2024-06-04 adds image for the placement of components in the qt micro sensor
2024-06-13 updates jucad tenn board file, now OLED screen pins are in the correct orientation
    [Tenn.kicad_pcb]
2024-06-13 changes revision of tenn board from 2.0 to 2.1
    [Tenn.kicad_pcb]
2024-06-21 Updates Tamashii K1tsun3, changes pinouts for Tenn board rev 2 and adds OLED and buttons functionality
    [Tei.kicad_sch]
2024-06-26 created inn BEC board
    [Inn BEC.kicad_pcb, Inn BEC.kicad_sch]
2024-07-05 Updates footprints in tenn.pcb, changes cap tantulum to 0805
    [Tenn.kicad_pcb, Tenn.kicad_sch]
2024-07-09 updates tenn pcb, redesign to rev 2.2, fixed problem with button not working
    [Tenn.kicad_pcb, Tenn.kicad_sch, Tou.kicad_pcb, Tou.kicad_sch]
2024-07-10 fixes error with tenn.pcb making it not possible to open, restpred files from backup
    [Tenn.kicad_pcb]
2024-07-10 Updates Tenn, Rev 2.2 now fixes issues with the buttons not working correctly, the screen orientation, it also uses new components, supporting up to 6s theorical
    [Tenn.kicad_pcb, Tenn.kicad_sch]
2024-07-16 added back silkscreen to tenn board
    [Tenn.kicad_pcb]
2024-08-05 Updates tenn pcb with new graphics and adds updated gerber and production files
    [Tenn.kicad_pcb, bom.csv, designators.csv, positions.csv]
2024-10-27 updatets K1tsun3 Tamashii, implements testmodes for Tenn board, and adds functionality to the buttons
2024-11-02 updates files for Tamashii
    [Tei.kicad_pcb]
2024-11-02 updates Tamashii k1tsun3, edging left and right, now working correctly and tested
    [main.cpp]
2024-12-02 Create Tenn_Board_With_Icons.ino
    Add code for displaying strategies with icons on Tenn board for a Minisumo robot
2025-01-24 Cahnges some files in PCB/tenn
    [Tenn.kicad_pcb, Tou.kicad_pcb, Tou.kicad_sch, bom.csv, designators.csv, positions.csv]
2025-01-24 Changes some files that couldn't load in PCB/tenn
    [Ma.kicad_pcb, Ma.kicad_sch, Tou.kicad_pcb, Tou.kicad_sch]
2025-05-15 README.md の更新
2025-06-08 updates files for INN BEC, adds production files and panelized version
    [Inn BEC.kicad_pcb, Inn BEC.kicad_sch, bom.csv, designators.csv, positions.csv]
2025-06-08 updates files on tenn pcb, fixes error with GND not being connected
    [Tenn.kicad_pcb]
2025-06-08 updates files of tenn pcb, changes foot print of 47uf capacitor, fixes unconnected vias and traces, adds Arduino GPIO references in the backside for easier understanding of the board
    [Tenn.kicad_pcb, Tenn.kicad_sch, bom.csv, designators.csv, positions.csv]
2025-07-28 creates schematic and PCB for MA minisumo board
    [Ma.kicad_pcb, Ma.kicad_sch, UART programmer.kicad_pcb, UART programmer.kicad_sch]
2025-07-28 updates MA PCB, adds logos
    [Ma.kicad_pcb]
2025-07-28 adds schematic PDF, panelized version of the boards and Production files for MA PCB
    [Ma.kicad_pcb, Ma_panelized.kicad_pcb, bom.csv, designators.csv, positions.csv]
2026-05-15 updated readme and PCB files
2026-07-19 created SHU BEC, added KiCad project files and production files
